santi4g022/PROTESIS-BI-NICA/HARDWARE/Diagrama_conexión.jpg

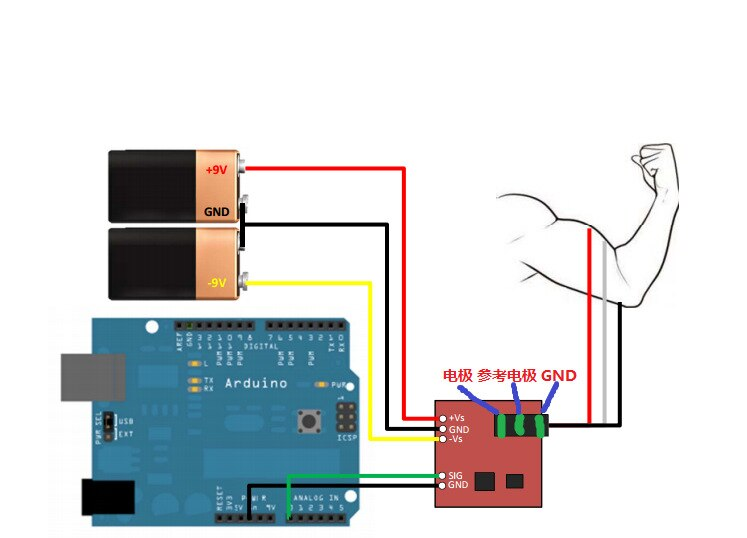
HARDWARE/Diagrama_conexión.jpg
