santi4g022/PROTESIS-BI-NICA/README.md

# PROTESIS-BIÓNICA
## Nombre del proyecto: Prototipo de prótesis antropomórfica para amputación transradial
### Integrantes del grupo: Santiago Pablo Torrico y Andres La Madrid

**Prótesis Biónica para Amputación Transradial**  

### Descripción Básica

El proyecto consiste en una prótesis biónica para amputación transradial, el cual es un dispositivo avanzado diseñado para restaurar las funciones motoras como el agarre de objetos, a personas con pérdida de extremidades a nivel del antebrazo. Este dispositivo utiliza biopotenciales mioeléctricos para controlar el movimiento de la prótesis a través de un módulo EMG, los cuales son interpretados por el MCU y se convierten en instrucciones para el servomotor que está encargado de la flexión de los dedos.

### Objetivo General

Desarrollar e implementar una prótesis funcional para amputaciones transradiales que
integre un sistema de control basado en señales de electromiografía (EMG) y mecanismos de
acción automática, mejorando así la usabilidad y la calidad de vida del usuario a un bajo costo de
fabricación.

**Este repositorio contiene el código modularizado, comentado, datasheet de diferentes componentes y archivos de la estructura.**
