santi4g022/PROTESIS-BI-NICA/HARDWARE/READMEHarware.md

## HARDWARE

Esta carpeta contiene todos los archivos y documentos relacionados con los componentes de hardware utilizados en el proyecto. Contiene esquemas de circuitos, diagramas de conexión y especificaciones técnicas.(datasheet)

### Lista de componentes y equipos utilizados:

- Muscle Sensor V3 Advancer Technologies.
- Arduino NANO.
- Metal Servo MG996R 180 degrees.
- Baterías 9V.
- Impresora 3D Matik V2.
