santi4g022/PROTESIS-BI-NICA/HARDWARE/DATASHEET/READMEDatasheet.md

## Datasheet

Esta carpeta contiene las hojas de datos o datasheets y documentación técnica relacionada con los componentes utilizados en el proyecto. Los archivos aquí incluidos proporcionan información detallada sobre las especificaciones, características y requisitos de los componentes de hardware.

### Lista de datasheet:
- Arduino NANO.
- Muscle Sensor V3.
- Metal Servo MG996R 180 degrees.
