santi4g022/PROTESIS-BI-NICA/SOFTWARE/READMESoftware.md

## SOFTWARE

Esta carpeta contiene todo el código fuente y recursos necesarios para el desarrollo y ejecución del proyecto. Contiene los archivos que definen la lógica del sistema, controlan el comportamiento del hardware y gestionan la interacción con los usuarios.

### Lista de programas y plataformas utilizadas
- Arduino IDE.
- Visual Studio Code.
- SolidWorks 2024.
- Ultimaker Cura.
- GitHub.
