santi4g022/PROTESIS-BI-NICA/(commit log)

2024-11-22 Lectura de señales 1
2024-11-29 Código modularizado y corrección en switch case
2024-11-29 Mapeo de señal
2024-12-09 Archivos de solidworks
2024-12-10 Integración de interrupción
